rgrokett/ESP8266_PIRv2/(threads)

Thread 2 (2017-09-13):

Wiring for regular ESP8266

franklinvv, 2017-09-13:
I suspect that this will only work with a ESP8266 Huzzah, right? The regular ESP8266 modules that I have all freeze when RST is held low, and come back to life again when RST rises again. With the wiring that you propose, a regular ESP8266 is disabled when motion is detected, and when it comes back to life motion is already gone because that's when the PIR outputs a low signal.

rgrokett, 2017-09-17:
I see this in the ESP8266 info:
_**RST** - this is the reset pin for the ESP8266, pulled high by default. When pulled down to ground momentarily it will reset the ESP8266 system. This pin is 5V compliant._

The PIR normally is LOW and goes HIGH with motion. Thus the 2N2222 is used to reverse this.

RST shouldn't be held low. Only momentarily set low then back to high. Try disconnecting the 2N2222 collector from GPIO16 and RST, then use a voltmeter to verify it is default High and goes Low when PIR detects motion then back High after motion stops.  You can also verify the PIR is going High during motion and Low otherwise. If it works oppositely, then the 2N2222 would not be needed.

Note that GPIO16 is used only to make sure the RST is High when no motion.  You may not need it, as long as the 2N2222 collector reads less than 2v when PIR detects motion and greater than 3v when PIR does not detect motion.

It should be the same for regular ESP8266 modules as the Huzzah.

Hope this helps

Closed 2017-09-28.

Thread 3 (2018-03-28):

PIR Pin not specified

jaajee, 2018-03-28:
In your v2 code you haven't specified the PIR sensor pin, how ESP will detect the motion?

rgrokett, 2018-03-29:
Deep Sleep mode works differently from regular GPIO monitoring.
Normally, the software is running in a loop watching for a GPIO event. But this means the ESP is active (and using a fair amount of power.)

But with Deep Sleep, the GPIO pin is controlling the ESP module itself, with the hardware and the program completely halted while in deep sleep, so the software doesn't need to monitor the PIR.  Only the PIR is still "awake". Motion on the PIR causes a reset (via the transistor) of the ESP8266 itself, causing it to effectively reboot. This starts the software running again which sends the message via WiFi, then resets the deep sleep trigger and halts the processor. The software really doesn't care what caused the ESP to start running again, it just sends a message every time it wakes up.

The difference in power drain is significant. A set of 3 AA batteries last only a week or two with "normal mode" running, but will last 6 months or more using deep sleep.

You can see the hardware design and the ESP's GPIO pin 16 used by deep sleep on page 7 of the PDF document.

Closed 2018-03-29.

Thread 5 (2019-03-08):

Battery life time

smoki3, 2019-03-08:
Hi,

is there a final comment how long the batteries lasts?

rgrokett, 2019-03-11:
With 3 AA batteries (4.5v) I've been getting about 6 months of usage, receiving several thousand transmissions during that time.

Thread 6 (2019-04-07):

"connection failed"

trcyprkr, 2019-04-07:
Hello sir,
I've checked and rechecked the sketch, editing and rechecking the ssl fingerprint many times.
I get a "connection failed" message every time regardless of what I try.
Any ideas?
