rgrokett/ESP8266_PIRv2/ESP8266_PIRv2/IFTTTCertificate.h

#pragma once

// Amazon Root CA 1. The live maker.ifttt.com chain was verified against this
// root on 2026-06-11. Root certificate validity ends 2038-01-17.
static const char IFTTT_ROOT_CA[] PROGMEM = R"EOF(
-----BEGIN CERTIFICATE-----
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
rqXRfboQnoZsG4q5WTP468SQvvG5
-----END CERTIFICATE-----
)EOF";
