rgrokett/ESP8266_PIRv2/ESP8266_PIRv2/secrets.example.h

#pragma once

// Copy this file to secrets.h and replace the placeholder values.
// secrets.h is intentionally excluded from version control.
constexpr char WIFI_SSID[] = "YOUR_WIFI_SSID";
constexpr char WIFI_PASSWORD[] = "YOUR_WIFI_PASSWORD";
constexpr char IFTTT_KEY[] = "YOUR_IFTTT_WEBHOOK_KEY";
constexpr char IFTTT_EVENT[] = "pirtrigger";

// Optional static IP configuration:
// #define USE_STATIC_IP
// const IPAddress STATIC_IP(192, 168, 1, 6);
// const IPAddress STATIC_GATEWAY(192, 168, 1, 1);
// const IPAddress STATIC_SUBNET(255, 255, 255, 0);
// const IPAddress STATIC_DNS(192, 168, 1, 1);
